yuxuan-steve-han/tacobell-compass/tacobell_logo.h

// Generated from Taco_Bell_2023.svg by tools/make_logo.py (48x54, 1 bit per pixel, MSB first).
#pragma once
#include <stdint.h>

#define TB_LOGO_W 48
#define TB_LOGO_H 54
#define TB_LOGO_STRIDE 6

static const uint8_t TB_LOGO[TB_LOGO_H * TB_LOGO_STRIDE] = {
  0x00, 0x00, 0x1F, 0xF8, 0x00, 0x00,
  0x00, 0x00, 0xFF, 0xFF, 0x00, 0x00,
  0x00, 0x01, 0xFF, 0xFF, 0xE0, 0x00,
  0x00, 0x00, 0xFF, 0xFF, 0xF8, 0x00,
  0x00, 0x00, 0x00, 0x7F, 0xFC, 0x00,
  0x00, 0x00, 0x00, 0x0F, 0xFE, 0x00,
  0x00, 0x80, 0x00, 0x07, 0xFF, 0x00,
  0x01, 0xC0, 0x00, 0x01, 0xFF, 0x80,
  0x03, 0x80, 0x00, 0x00, 0xFF, 0xC0,
  0x07, 0x80, 0x00, 0x00, 0x7F, 0xE0,
  0x0F, 0x00, 0x00, 0x00, 0x3F, 0xF0,
  0x0E, 0x00, 0x00, 0x00, 0x1F, 0xF8,
  0x1E, 0x00, 0x00, 0x00, 0x0F, 0xF8,
  0x3C, 0x00, 0x00, 0x00, 0x07, 0xFC,
  0x3C, 0x00, 0x00, 0x00, 0x03, 0xFC,
  0x38, 0x00, 0x00, 0x00, 0x01, 0xFE,
  0x78, 0x00, 0x00, 0x00, 0x00, 0x1E,
  0x78, 0x00, 0x00, 0x00, 0x00, 0x02,
  0x78, 0x00, 0x00, 0x00, 0x00, 0x00,
  0xF8, 0x00, 0x00, 0x00, 0x00, 0x00,
  0xF8, 0x00, 0x00, 0x00, 0x00, 0x00,
  0xF8, 0x00, 0x00, 0x00, 0x00, 0x00,
  0xF8, 0x00, 0x04, 0x00, 0x00, 0xC0,
  0xF8, 0x00, 0x18, 0x00, 0x0F, 0xE0,
  0xFC, 0x00, 0x60, 0x00, 0x7F, 0xE1,
  0xFC, 0x01, 0xC0, 0x01, 0xFF, 0xE1,
  0xFC, 0x07, 0x00, 0x07, 0xFF, 0xE3,
  0xFC, 0x0E, 0x00, 0x1F, 0xFF, 0xC7,
  0xFC, 0x18, 0x00, 0x7F, 0xFF, 0x87,
  0xFE, 0x70, 0x01, 0xFF, 0xFF, 0x8F,
  0xFE, 0xE0, 0x03, 0x3F, 0xFF, 0x1F,
  0xFF, 0xC0, 0x0E, 0x3F, 0xFC, 0x3F,
  0xFF, 0x80, 0x18, 0x3F, 0xF8, 0x7F,
  0xFF, 0x00, 0x70, 0x3F, 0xF1, 0xFF,
  0xFE, 0x00, 0xC0, 0x3F, 0xC3, 0xFF,
  0xFE, 0x01, 0x80, 0x7F, 0x87, 0xFF,
  0xFC, 0x03, 0x00, 0xFE, 0x1F, 0xFF,
  0xF8, 0x07, 0x81, 0xFC, 0x7F, 0xFF,
  0xF8, 0x0F, 0xFF, 0xF0, 0xFF, 0xFF,
  0xF8, 0x0F, 0xFF, 0x83, 0xFF, 0xFF,
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
};
