yuxuan-steve-han/tacobell-compass/(commit log)

2026-09-28 Taco Bell compass: GPS nearest-location finder with pixel-art UI
    [case.scad, case.stl]
2026-09-28 enable switch hole
    [case.scad]
2026-09-28 Add tilt-compensated compass with multi-chip magnetometer support
    - QMC5883L (0x0D), QMC5883P (0x2C) or HMC5883L (0x1E) on Wire1 (GPIO 15/16),
    tilt-compensated with the board's QMI8658 accelerometer
    - Detect chips that answer but send no data, report idle bus levels
    - Serial commands: c = calibrate (saved to flash), d = debug output
    - Drop the unused Waveshare QMI8658 driver
    - README: compass wiring and calibration
2026-09-28 Fix compass
    [case.scad, case.stl, partitions.csv]
2026-09-28 Some minor fixes probably
    [tacobell_compass.ino]
